arctoros/zebra/Hardware/VGA/finch.png

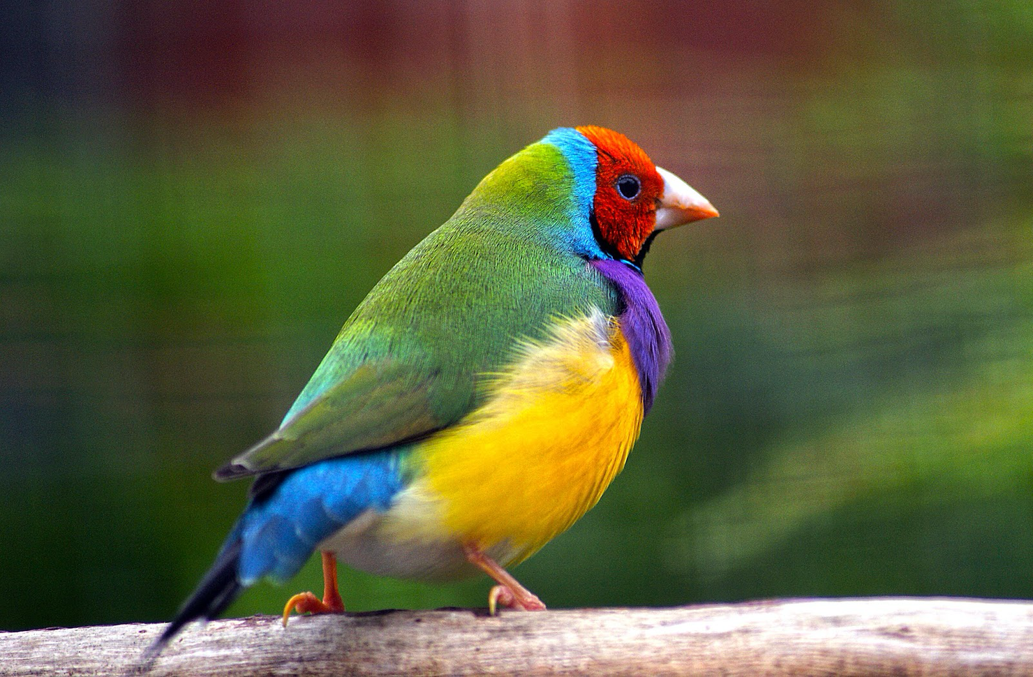
Hardware/VGA/finch.png
