arctoros/zebra/Hardware/VGA/finch4bit.png

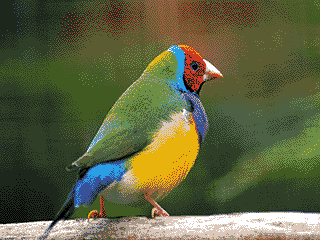
Hardware/VGA/finch4bit.png
