arctoros/zebra/Hardware/baud.xlsx

IOCLOCK | 3686400
Baud rate | 16
SIO Should be sending one bit every: | 0.0000043403 | s
One byte + start, parity, stop every: | 0.0000477431
SIO should be sending one byte every: | 381.9444444 | cycles
SIO IS sending one byte every: | 790 | cycles
every cycle lasts | 1.25e-07 | s
 | 9.875e-05
20945.45455 | 2.343217451
