arctoros/zebra/Hardware/Keyboard Map.xlsx

Index | IndexHex | Port B | Port A | Sign | Sec. Sign | ASCII | Sec. ASCII | Port B | Port A | Port B | Port A |  | Index
0 | 0 | 0 | 0 | ` | ~ | 60 | 7E | 00000001 | 00000001 | 0 | 0 | 0 | 0
1 | 1 | 0 | 1 | 8 | * | 38 | 2A | 00000001 | 00000010 | 0 | 1 | 0 | 1
2 | 2 | 0 | 2 | Tab |  | 0 | 0 | 00000001 | 00000100 | 0 | 2 | 0 | 2
3 | 3 | 0 | 3 | i | I | 69 | 49 | 00000001 | 00001000 | 0 | 3 | 0 | 3
4 | 4 | 0 | 4 | Esc |  | 1B | 0 | 00000001 | 00010000 | 0 | 4 | 0 | 4
5 | 5 | 0 | 5 | k | K | 6B | 4B | 00000001 | 00100000 | 0 | 5 | 0 | 5
6 | 6 | 0 | 6 | Shift |  | 0 | 0 | 00000001 | 01000000 | 0 | 6 | 0 | 6
7 | 7 | 0 | 7 | , | < | 2C | 3C | 00000001 | 10000000 | 0 | 7 | 0 | 7
8 | 8 | 1 | 0 | 1 | ! | 31 | 21 | 00000010 | 00000001 | 1 | 0 | 8 | 8
9 | 9 | 1 | 1 | 9 | ( | 39 | 28 | 00000010 | 00000010 | 1 | 1 | 8 | 9
10 | A | 1 | 2 | q | Q | 71 | 51 | 00000010 | 00000100 | 1 | 2 | 8 | 10
11 | B | 1 | 3 | o | O | 6F | 4F | 00000010 | 00001000 | 1 | 3 | 8 | 11
12 | C | 1 | 4 | a | A | 61 | 41 | 00000010 | 00010000 | 1 | 4 | 8 | 12
13 | D | 1 | 5 | l | L | 6C | 4C | 00000010 | 00100000 | 1 | 5 | 8 | 13
14 | E | 1 | 6 | z | Z | 7A | 5A | 00000010 | 01000000 | 1 | 6 | 8 | 14
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
