arctoros/zebra/Hardware/VGA/voltages.xlsx

r1 | r2 | r3 | r4 | number | perfect | reality | difference | 2nd try | difference | 3nd try | difference | 4nd try | difference
0 | 0 | 0 | 0 | 0 | 0 | 0 | 0.000 | 0 | 0.000 | 0 | 0.000 | 0 | 0.000
0 | 0 | 0 | 1 | 1 | 0.04666666667 | 0.07 | 0.023 | 0.052 | 0.005 | 0.064 | 0.017 | 0.064 | 0.017
0 | 0 | 1 | 0 | 2 | 0.09333333333 | 0.122 | 0.029 | 0.11 | 0.017 | 0.118 | 0.025 | 0.118 | 0.025 | higher
0 | 0 | 1 | 1 | 3 | 0.14 | 0.172 | 0.032 | 0.148 | 0.008 | 0.166 | 0.026 | 0.166 | 0.026
0 | 1 | 0 | 0 | 4 | 0.1866666667 | 0.222 | 0.035 | 0.18 | -0.007 | 0.23 | 0.043 | 0.222 | 0.035 | higher
0 | 1 | 0 | 1 | 5 | 0.2333333333 | 0.26 | 0.027 | 0.216 | -0.017 | 0.26 | 0.027 | 0.266 | 0.033
0 | 1 | 1 | 0 | 6 | 0.28 | 0.316 | 0.036 | 0.272 | -0.008 | 0.31 | 0.030 | 0.304 | 0.024
0 | 1 | 1 | 1 | 7 | 0.3266666667 | 0.346 | 0.019 | 0.308 | -0.019 | 0.352 | 0.025 | 0.338 | 0.011
1 | 0 | 0 | 0 | 8 | 0.3733333333 | 0.416 | 0.043 | 0.37 | -0.003 | 0.384 | 0.011 | 0.384 | 0.011
1 | 0 | 0 | 1 | 9 | 0.42 | 0.462 | 0.042 | 0.402 | -0.018 | 0.434 | 0.014 | 0.434 | 0.014
1 | 0 | 1 | 0 | 10 | 0.4666666667 | 0.504 | 0.037 | 0.458 | -0.009 | 0.446 | -0.021 | 0.446 | -0.021
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
