arctoros/zebra/Hardware/VGA/finch8bitgray.png

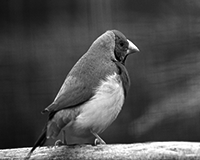
Hardware/VGA/finch8bitgray.png
