arctoros/zebra/Software/vga/converter/finch.png

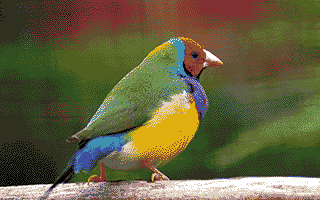
Software/vga/converter/finch.png
