arctoros/zebra/Hardware/Top.step

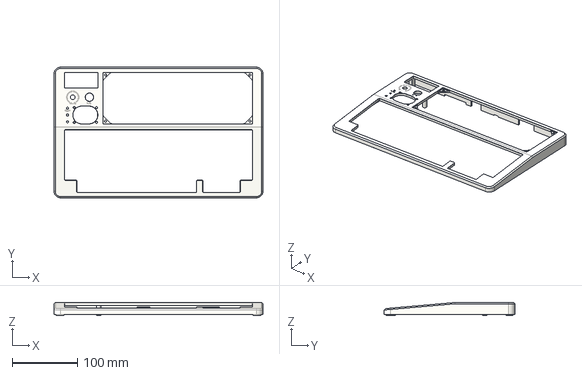
[picture p5: CAD file, 2025-11-17]
Hardware/Top.step
320.0 x 200.0 x 19.9 mm
