arctoros/zebra/Schematics/Symbols & Footprints/3D-Models/PLCC-68.stp

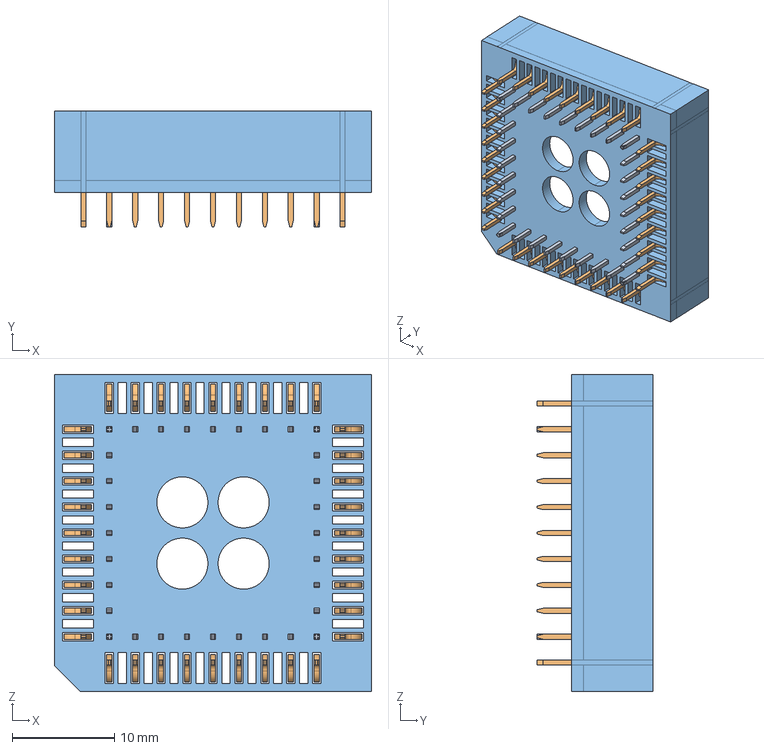
[picture p6: CAD file, 2025-11-17]
Schematics/Symbols & Footprints/3D-Models/PLCC-68.stp
31.1 x 11.4 x 31.1 mm
