arctoros/zebra/Hardware/Bottom.step

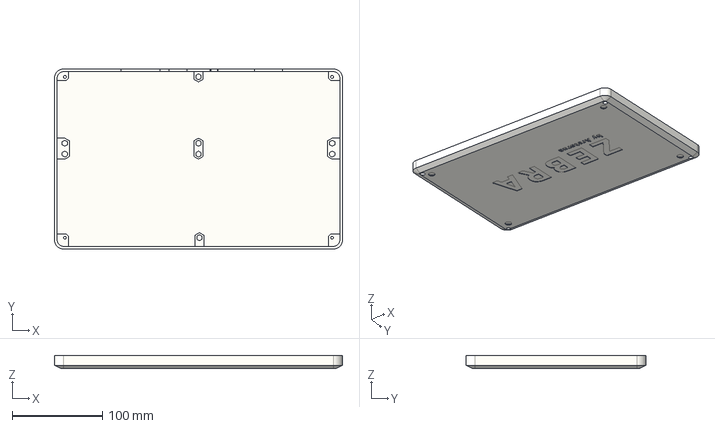
[picture p7: CAD file, 2025-11-17]
Hardware/Bottom.step
320.0 x 200.0 x 14.9 mm
