arctoros/zebra/Schematics/Symbols & Footprints/3D-Models/ZIF.stp

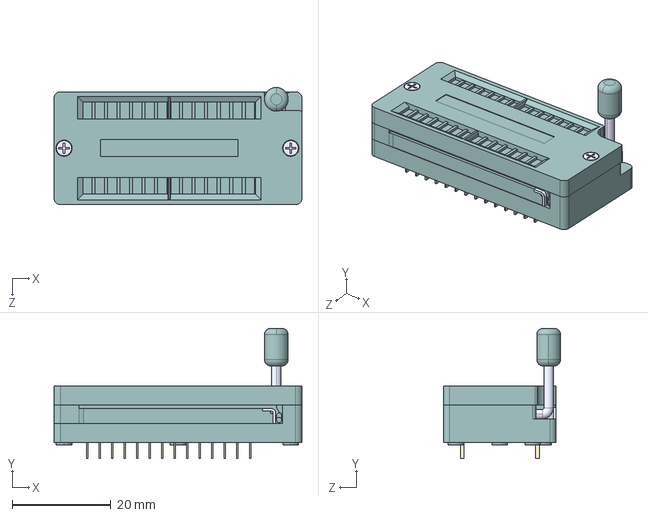
[picture p8: CAD file, 2025-11-17]
Schematics/Symbols & Footprints/3D-Models/ZIF.stp
50.3 x 26.4 x 23.7 mm
