arctoros/zebra/Schematics/Symbols & Footprints/3D-Models/PLCC-44.stp

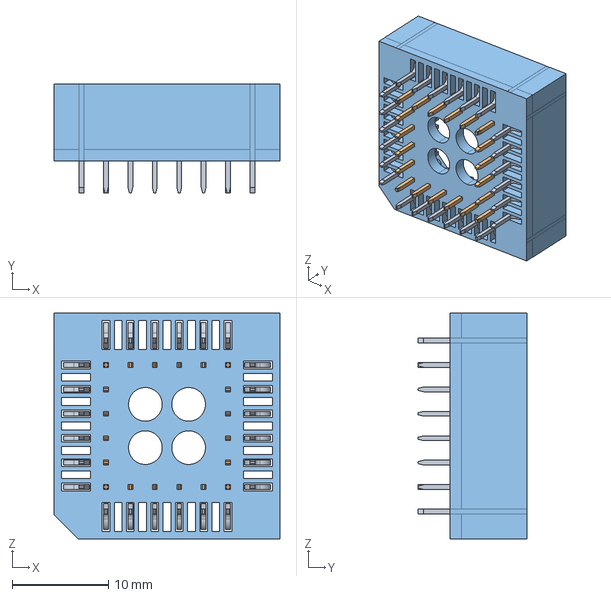
[picture p9: CAD file, 2025-11-17]
Schematics/Symbols & Footprints/3D-Models/PLCC-44.stp
23.5 x 11.4 x 23.5 mm
