arctoros/zebra/Schematics/Symbols & Footprints/3D-Models/MX.stp

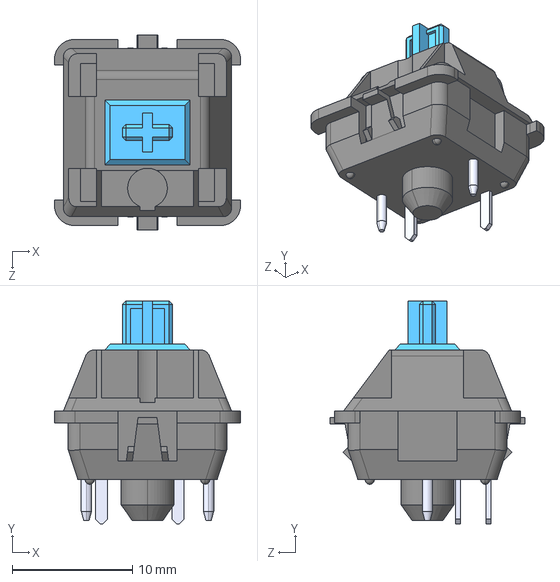
[picture p10: CAD file, 2025-11-17]
Schematics/Symbols & Footprints/3D-Models/MX.stp
15.5 x 18.5 x 16.2 mm
