arctoros/zebra/Schematics/Symbols & Footprints/3D-Models/PLCC-84.stp

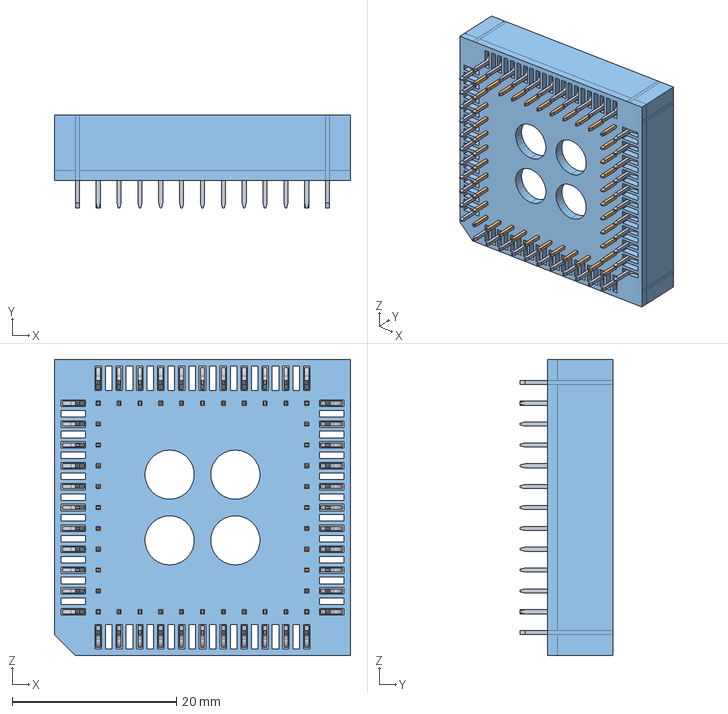
[picture p11: CAD file, 2025-11-17]
Schematics/Symbols & Footprints/3D-Models/PLCC-84.stp
36.1 x 11.4 x 36.0 mm
