arctoros/zebra/Schematics/Symbols & Footprints/3D-Models/POT.stp

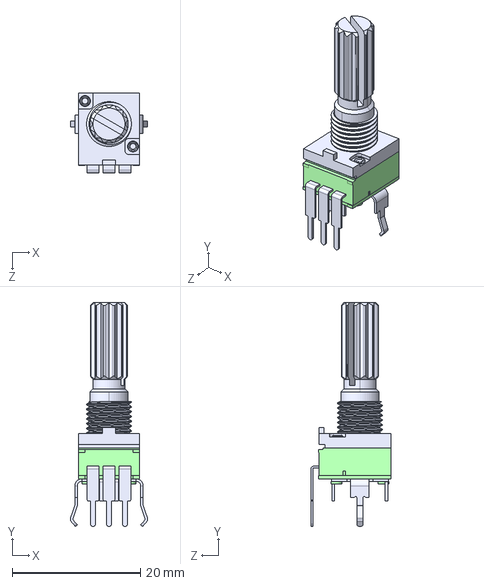
[picture p12: CAD file, 2025-11-17]
Schematics/Symbols & Footprints/3D-Models/POT.stp
12.1 x 35.0 x 12.5 mm
