arctoros/zebra/Schematics/Z80.kicad_sch

## KiCad design Schematics/Z80.kicad_sch (2025-11-17)

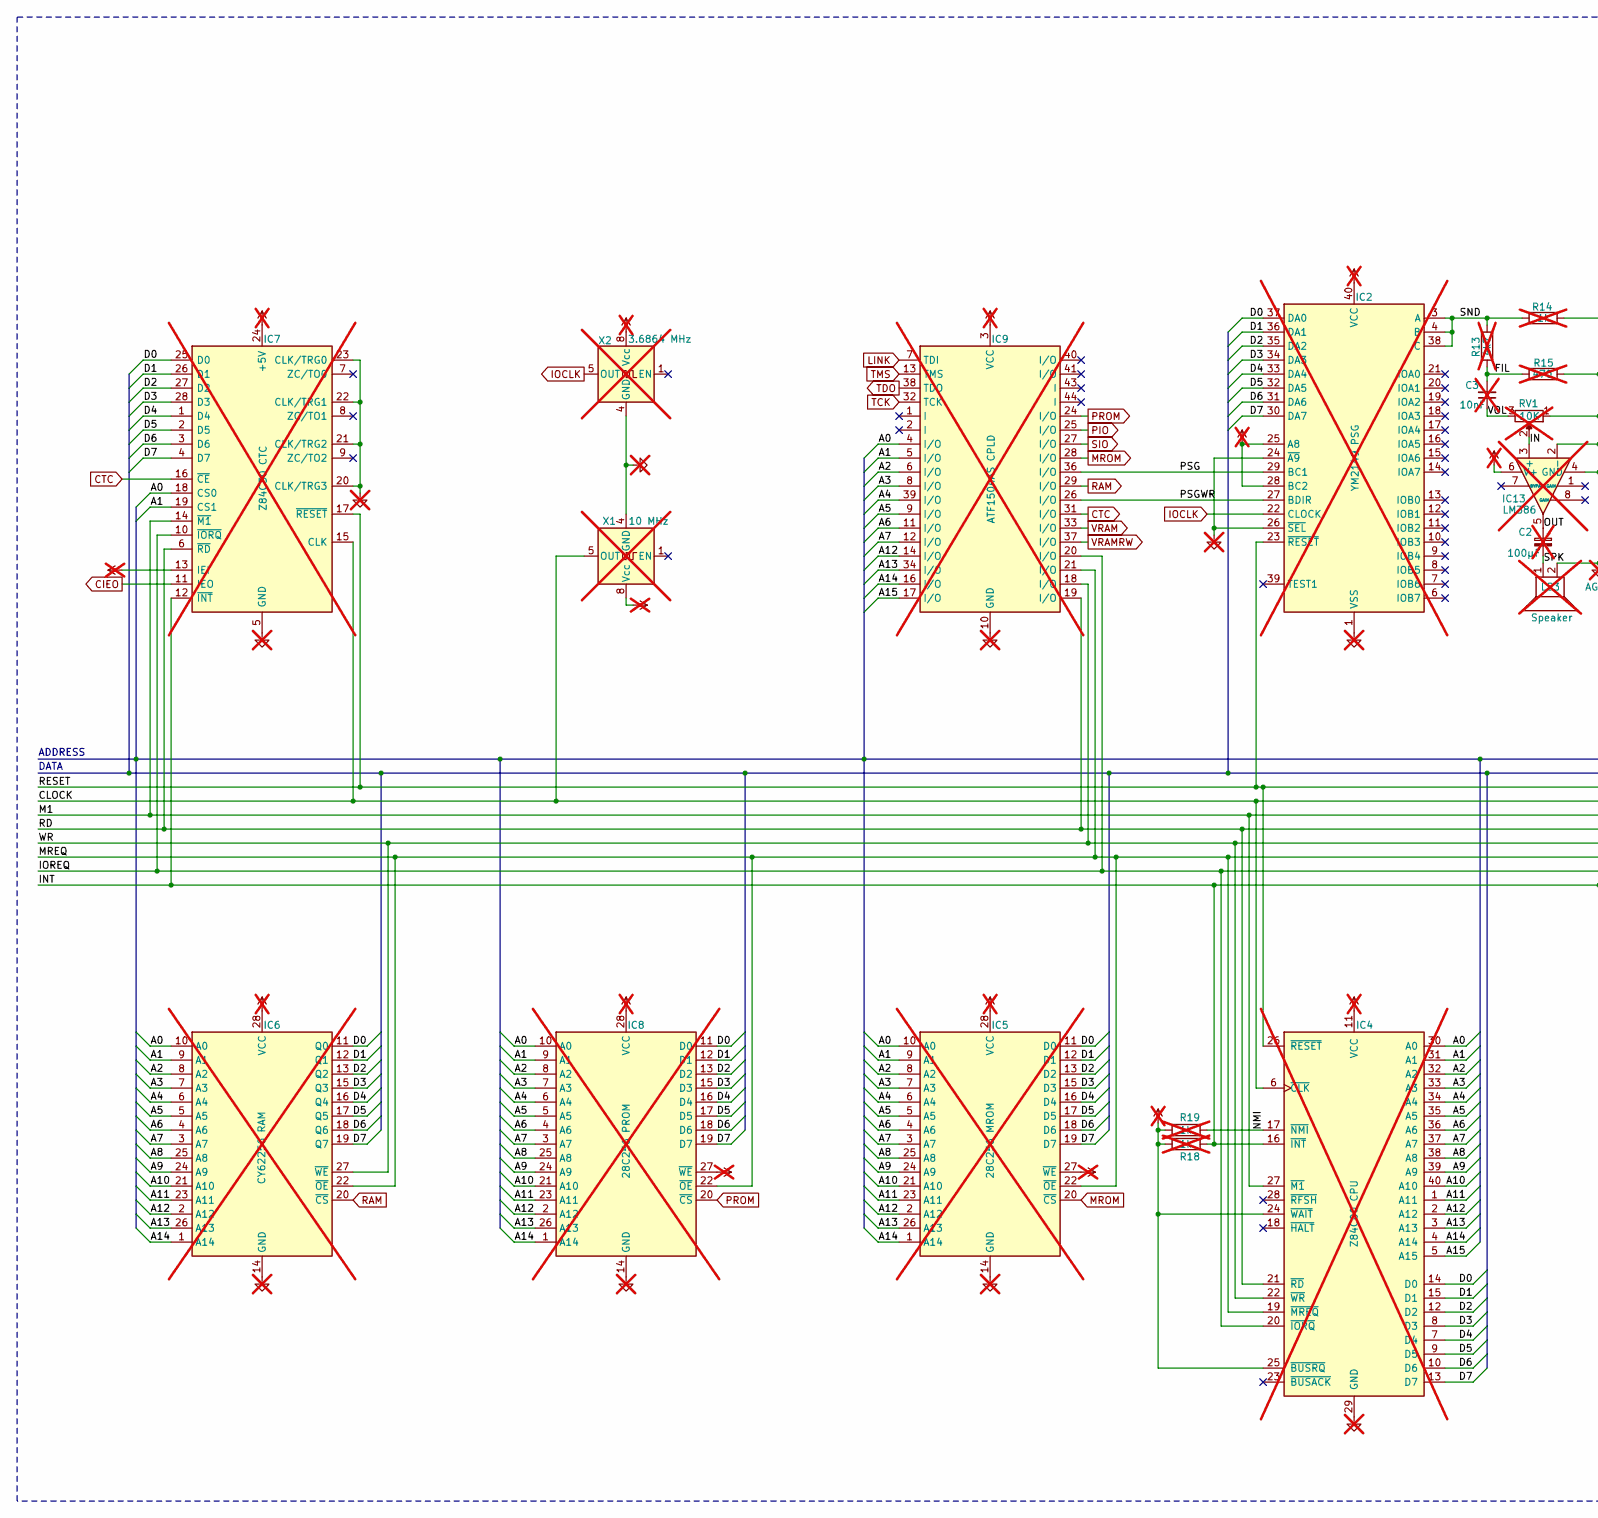
[picture p13: schematic Z80.kicad_sch, part in row 1, column 1]

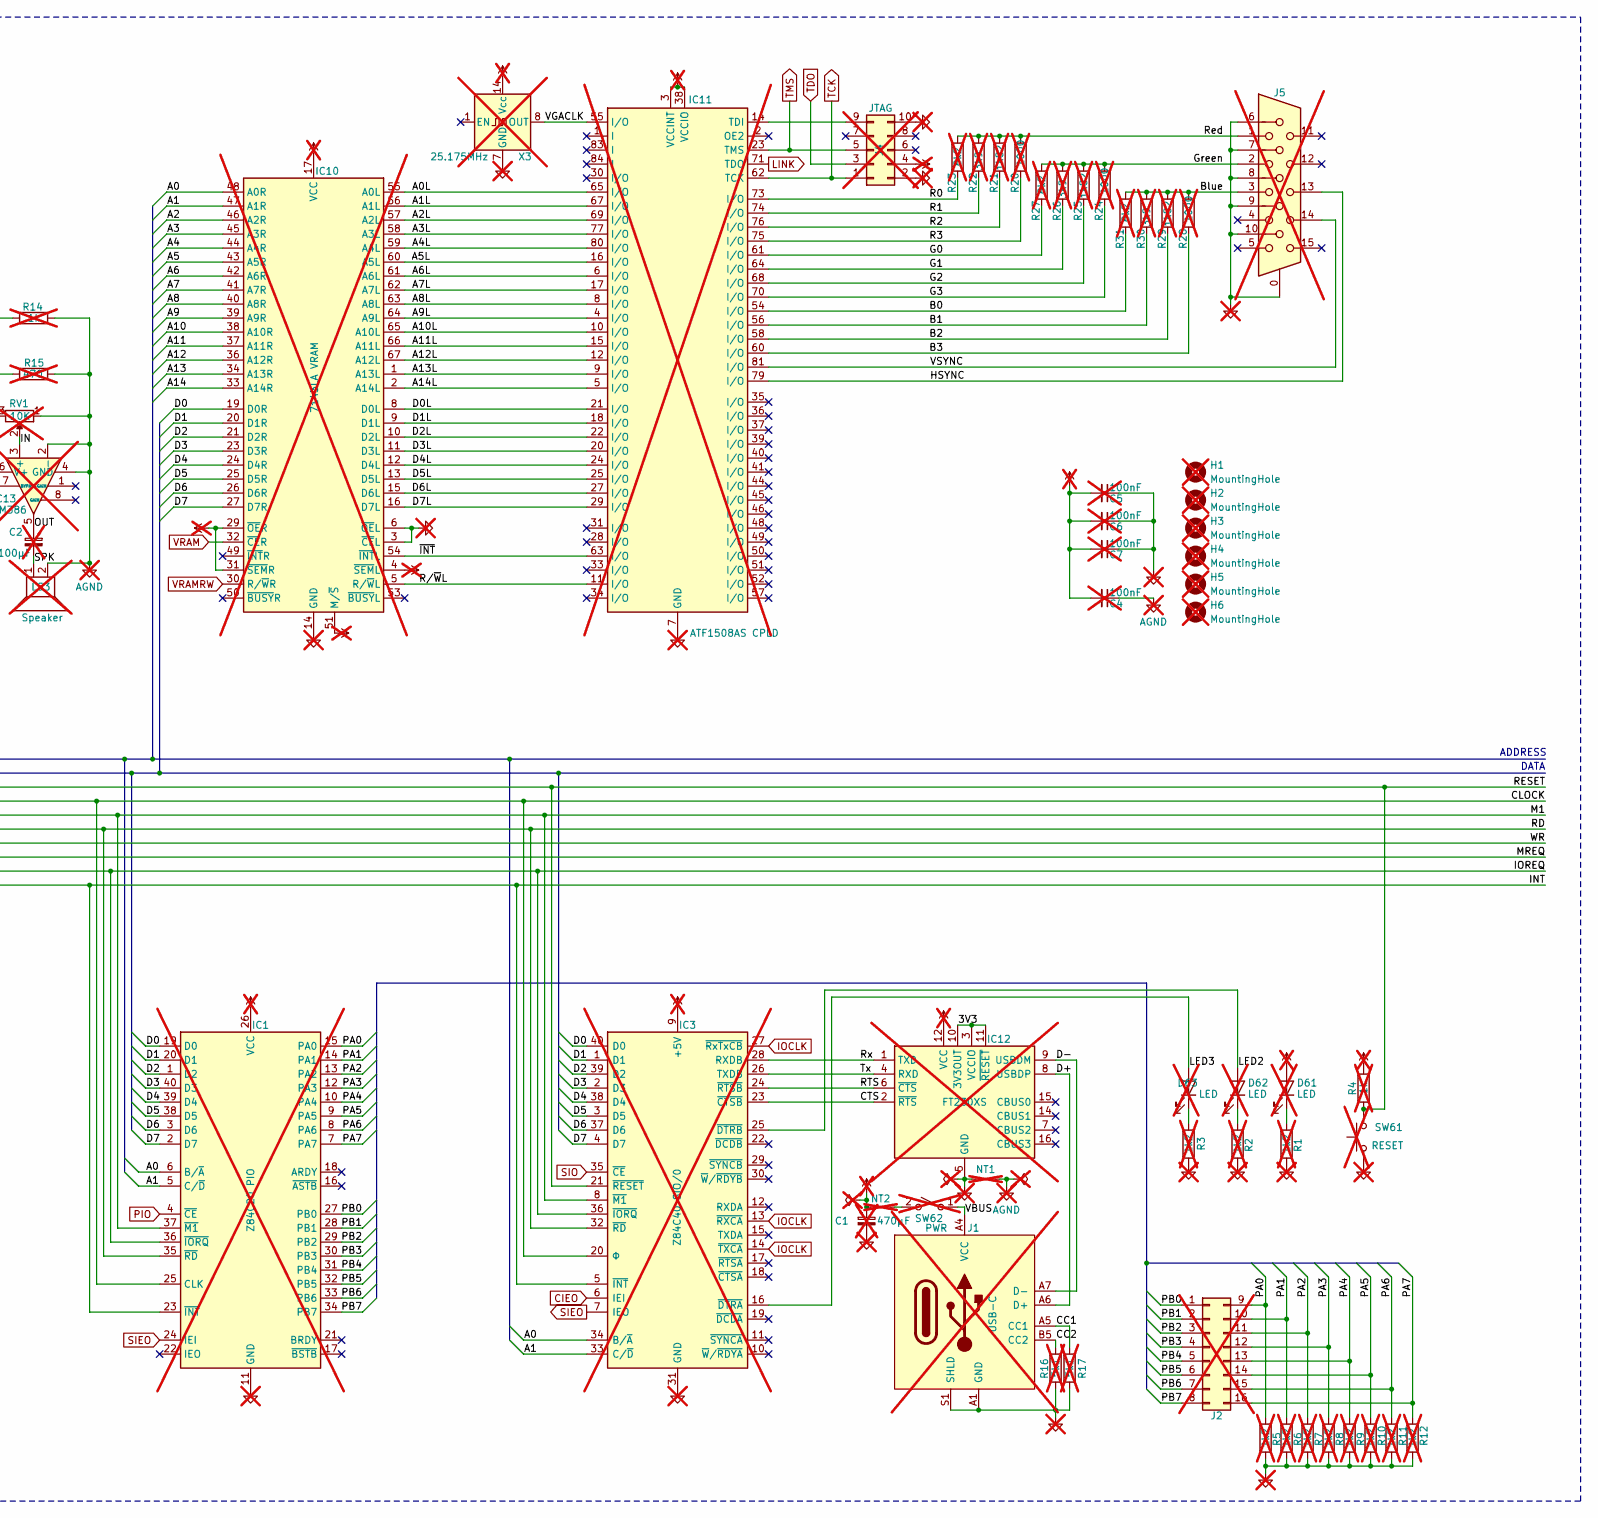
[picture p14: schematic Z80.kicad_sch, part in row 1, column 2]

Parts:
C1: 470μF; CP_Radial_D8.0mm; not fitted
C2: 100μF; CP_Radial_D5.0; not fitted
C3: 10nF; C_Disc_D3.0mm_W1.6mm_P2.50mm; not fitted
C4, C5, C6, C7: 100nF; C_Disc_D3.0mm_W1.6mm_P2.50mm; not fitted
D61, D62, D63: LED; LED_D3.0mm; not fitted
H1, H2, H3, H4, H5, H6: MountingHole; MountingHole_3.2mm_M3; not fitted
IC1: Z84C20 PIO; DIP-40_W15.24mm_Socket; LCSC Part # C2332; not fitted
IC2: YM2149 PSG; DIP-40_W15.24mm_Socket; LCSC Part # C2332; not fitted
IC3: Z84C40 SIO/0; DIP-40_W15.24mm_Socket; Manufacturer_Part_Number Z84C4206PEG; Mouser Part Number 692-Z84C4206PEG; not fitted
IC4: Z84C00 CPU; DIP-40_W15.24mm_Socket; LCSC Part # C2332; not fitted
IC5: 28C256 MROM; DIP-28_W15.24mm_Socket; not fitted
IC6: CY62256 RAM; DIP-28_W15.24mm_Socket; not fitted
IC7: Z84C30 CTC; DIP-28_W15.24mm_Socket; Manufacturer_Part_Number Z84C3010PEG; Mouser Part Number 692-Z84C3010PEG; not fitted
IC8: 28C256 PROM; DIP-28_W15.24mm_Socket; not fitted
IC9: ATF1504AS CPLD; PLCC-44_THT-Socket; not fitted
IC10: 7143LA VRAM; PLCC-68_THT-Socket; not fitted
IC11: ATF1508AS CPLD; PLCC-84_THT-Socket; not fitted
IC12: FT230XS; SSOP-16_3.9x4.9mm_P0.635mm; LCSC Part # C69082; not fitted
IC13: LM386; DIP-8_W7.62mm_Socket; not fitted
J1: USB-C; USB-C-New; LCSC Part # C2840393; not fitted
J2: Keyboard; PinSocket_1x16; not fitted
J4: JTAG; PinHeader_2x05_P2.54mm_Vertical; not fitted
J5: VGA; DSUB-15; not fitted
LS3: Speaker; PinHeader_1x02_P2.54mm_Vertical; not fitted
NT1: AGND; NetTie; not fitted
NT2: 5V; NetTie1.8; not fitted
R1, R2, R3, R5, R6, R7, R8, R9, R10, R11, R12: 1k2; R_Standard; not fitted
R4, R14, R18, R19: 1k; R_Standard; not fitted
R13: 4k7; R_Standard; not fitted
R15: 470; R_Standard; not fitted
R16, R17: 5k1; R_Standard; not fitted
R20, R24, R28: 1000; R_Standard; not fitted
R21, R25, R29: 1k82; R_Standard; not fitted
R22, R26, R30: 3k9; R_Standard; not fitted
R23, R27, R31: 8k2; R_Standard; not fitted
RV1: 10K; Potentiometer_Alpha_RD901F-40-00D_Single_Vertical_CircularH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; not fitted
SW61: RESET; PinHeader_1x02_P2.54mm_Vertical; not fitted
SW62: PWR; PinHeader_1x02_P2.54mm_Vertical; not fitted
X1: 10 MHz; Oscillator_DIP-8; not fitted
X2: 3.6864 MHz; Oscillator_DIP-8; not fitted
X3: 25.175MHz; Oscillator_DIP-14; not fitted

Connections:
3V3: IC12.3 (VCCIO), IC12.10 (3V3OUT), IC12.11 (~RESET)
+5V: C1.1, C4.2, C5.2, C6.2, C7.2, D61.2 (A), IC1.26 (VCC), IC2.25 (A8), IC2.28 (BC2), IC2.40 (VCC), IC3.9 (+5V), IC4.11 (VCC), IC4.24 (~WAIT), IC4.25 (~BUSRQ), IC5.27 (~WE), IC5.28 (VCC), IC6.28 (VCC), IC7.13 (IEI), IC7.24 (+5V), IC8.27 (~WE), IC8.28 (VCC), IC9.3 (VCC), IC9.15 (VCC), IC9.23 (VCC), IC9.35 (VCC), IC10.4 (~SEML), IC10.17 (VCC), IC10.22 (VCC), IC10.29 (~OER), IC10.31 (~SEMR), IC10.51 (M/~S), IC10.68 (VCC), IC11.3 (VCCINT), IC11.13 (VCCIO), IC11.26 (VCCIO), IC11.38 (VCCIO), IC11.43 (VCCIO), IC11.53 (VCCIO), IC11.66 (VCCIO), IC11.78 (VCCIO), IC12.12 (VCC), IC13.6 (V+), J4.4, NT2.2, R4.2, R18.2, R19.2, X1.8 (Vcc), X2.8 (Vcc), X3.14 (Vcc)
A0: IC1.6 (B/~A), IC3.34 (B/~A), IC4.30 (A0), IC5.10 (A0), IC6.10 (A0), IC7.18 (CS0), IC8.10 (A0), IC9.4 (I/O), IC10.48 (A0R)
A0L: IC10.55 (A0L), IC11.65 (I/O)
A1: IC1.5 (C/~D), IC3.33 (C/~D), IC4.31 (A1), IC5.9 (A1), IC6.9 (A1), IC7.19 (CS1), IC8.9 (A1), IC9.5 (I/O), IC10.47 (A1R)
A1L: IC10.56 (A1L), IC11.67 (I/O)
A2: IC4.32 (A2), IC5.8 (A2), IC6.8 (A2), IC8.8 (A2), IC9.6 (I/O), IC10.46 (A2R)
A2L: IC10.57 (A2L), IC11.69 (I/O)
A3: IC4.33 (A3), IC5.7 (A3), IC6.7 (A3), IC8.7 (A3), IC9.8 (I/O), IC10.45 (A3R)
A3L: IC10.58 (A3L), IC11.77 (I/O)
A4: IC4.34 (A4), IC5.6 (A4), IC6.6 (A4), IC8.6 (A4), IC9.39 (I/O), IC10.44 (A4R)
A4L: IC10.59 (A4L), IC11.80 (I/O)
A5: IC4.35 (A5), IC5.5 (A5), IC6.5 (A5), IC8.5 (A5), IC9.9 (I/O), IC10.43 (A5R)
A5L: IC10.60 (A5L), IC11.16 (I/O)
A6: IC4.36 (A6), IC5.4 (A6), IC6.4 (A6), IC8.4 (A6), IC9.11 (I/O), IC10.42 (A6R)
A6L: IC10.61 (A6L), IC11.6 (I/O)
A7: IC4.37 (A7), IC5.3 (A7), IC6.3 (A7), IC8.3 (A7), IC9.12 (I/O), IC10.41 (A7R)
A7L: IC10.62 (A7L), IC11.17 (I/O)
A8: IC4.38 (A8), IC5.25 (A8), IC6.25 (A8), IC8.25 (A8), IC10.40 (A8R)
A8L: IC10.63 (A8L), IC11.8 (I/O)
A9: IC4.39 (A9), IC5.24 (A9), IC6.24 (A9), IC8.24 (A9), IC10.39 (A9R)
A9L: IC10.64 (A9L), IC11.4 (I/O)
A10: IC4.40 (A10), IC5.21 (A10), IC6.21 (A10), IC8.21 (A10), IC10.38 (A10R)
A10L: IC10.65 (A10L), IC11.10 (I/O)
A11: IC4.1 (A11), IC5.23 (A11), IC6.23 (A11), IC8.23 (A11), IC10.37 (A11R)
A11L: IC10.66 (A11L), IC11.15 (I/O)
A12: IC4.2 (A12), IC5.2 (A12), IC6.2 (A12), IC8.2 (A12), IC9.14 (I/O), IC10.36 (A12R)
A12L: IC10.67 (A12L), IC11.12 (I/O)
A13: IC4.3 (A13), IC5.26 (A13), IC6.26 (A13), IC8.26 (A13), IC9.34 (I/O), IC10.34 (A13R)
A13L: IC10.1 (A13L), IC11.9 (I/O)
A14: IC4.4 (A14), IC5.1 (A14), IC6.1 (A14), IC8.1 (A14), IC9.16 (I/O), IC10.33 (A14R)
A14L: IC10.2 (A14L), IC11.5 (I/O)
A15: IC4.5 (A15), IC9.17 (I/O)
AGND: C4.1, IC13.2 (-), IC13.4 (GND), LS3.2, NT1.2, R14.2, R15.2, RV1.1
B0: IC11.54 (I/O), R31.2
B1: IC11.56 (I/O), R30.2
B2: IC11.58 (I/O), R29.2
B3: IC11.60 (I/O), R28.2
Blue: J5.3, R28.1, R29.1, R30.1, R31.1
CC1: J1.A5 (CC1), R17.1
CC2: J1.B5 (CC2), R16.1
CIEO: IC3.6 (IEI), IC7.11 (IEO)
CLOCK: IC1.25 (CLK), IC3.20 (Φ), IC4.6 (~CLK), IC7.15 (CLK), X1.5 (OUT)
CTC: IC7.16 (~CE), IC9.31 (I/O)
CTS: IC3.23 (~CTSB), IC12.2 (~RTS)
D0: IC1.19 (D0), IC2.37 (DA0), IC3.40 (D0), IC4.14 (D0), IC5.11 (D0), IC6.11 (Q0), IC7.25 (D0), IC8.11 (D0), IC10.19 (D0R)
D0L: IC10.8 (D0L), IC11.21 (I/O)
D1: IC1.20 (D1), IC2.36 (DA1), IC3.1 (D1), IC4.15 (D1), IC5.12 (D1), IC6.12 (Q1), IC7.26 (D1), IC8.12 (D1), IC10.20 (D1R)
D1L: IC10.9 (D1L), IC11.18 (I/O)
D2: IC1.1 (D2), IC2.35 (DA2), IC3.39 (D2), IC4.12 (D2), IC5.13 (D2), IC6.13 (Q2), IC7.27 (D2), IC8.13 (D2), IC10.21 (D2R)
D2L: IC10.10 (D2L), IC11.22 (I/O)
D3: IC1.40 (D3), IC2.34 (DA3), IC3.2 (D3), IC4.8 (D3), IC5.15 (D3), IC6.15 (Q3), IC7.28 (D3), IC8.15 (D3), IC10.23 (D3R)
D3L: IC10.11 (D3L), IC11.20 (I/O)
D4: IC1.39 (D4), IC2.33 (DA4), IC3.38 (D4), IC4.7 (D4), IC5.16 (D4), IC6.16 (Q4), IC7.1 (D4), IC8.16 (D4), IC10.24 (D4R)
D4L: IC10.12 (D4L), IC11.24 (I/O)
D5: IC1.38 (D5), IC2.32 (DA5), IC3.3 (D5), IC4.9 (D5), IC5.17 (D5), IC6.17 (Q5), IC7.2 (D5), IC8.17 (D5), IC10.25 (D5R)
D5L: IC10.13 (D5L), IC11.25 (I/O)
D6: IC1.3 (D6), IC2.31 (DA6), IC3.37 (D6), IC4.10 (D6), IC5.18 (D6), IC6.18 (Q6), IC7.3 (D6), IC8.18 (D6), IC10.26 (D6R)
D6L: IC10.15 (D6L), IC11.27 (I/O)
D7: IC1.2 (D7), IC2.30 (DA7), IC3.4 (D7), IC4.13 (D7), IC5.19 (D7), IC6.19 (Q7), IC7.4 (D7), IC8.19 (D7), IC10.27 (D7R)
D7L: IC10.16 (D7L), IC11.29 (I/O)
D+: IC12.8 (USBDP), J1.A6 (D+), J1.B6 (D+)
D-: IC12.9 (USBDM), J1.A7 (D-), J1.B7 (D-)
FIL: C3.2, R13.1, R15.1
G0: IC11.61 (I/O), R27.2
G1: IC11.64 (I/O), R26.2
G2: IC11.68 (I/O), R25.2
G3: IC11.70 (I/O), R24.2
GND: C1.2, C5.1, C6.1, C7.1, IC1.11 (GND), IC2.1 (VSS), IC2.24 (~A9), IC2.26 (~SEL), IC3.31 (GND), IC4.29 (GND), IC5.14 (GND), IC6.14 (GND), IC7.5 (GND), IC7.20 (CLK/TRG3), IC7.21 (CLK/TRG2), IC7.22 (CLK/TRG1), IC7.23 (CLK/TRG0), IC8.14 (GND), IC9.10 (GND), IC9.22 (GND), IC9.30 (GND), IC9.42 (GND), IC10.3 (~CEL), IC10.6 (~OEL), IC10.14 (GND), IC10.18 (GND), IC10.35 (GND), IC10.52 (GND), IC11.7 (GND), IC11.19 (GND), IC11.32 (GND), IC11.42 (GND), IC11.47 (GND), IC11.59 (GND), IC11.72 (GND), IC11.82 (GND), IC12.5 (GND), IC12.13 (GND), J1.A1 (GND), J1.A12 (GND), J1.B1 (GND), J1.B12 (GND), J1.S1 (SHLD), J4.2, J4.10, J5.0, J5.6, J5.7, J5.8, J5.9, J5.10, NT1.1, R1.2, R2.2, R3.2, R5.2, R6.2, R7.2, R8.2, R9.2, R10.2, R11.2, R12.2, R16.2, R17.2, SW61.2 (B), X1.4 (GND), X2.4 (GND), X3.7 (GND)
Green: J5.2, R24.1, R25.1, R26.1, R27.1
HSYNC: IC11.79 (I/O), J5.13
IN: IC13.3 (+), RV1.2
INT: IC1.23 (~INT), IC3.5 (~INT), IC4.16 (~INT), IC7.12 (~INT), R18.1
IOCLK: IC2.22 (CLOCK), IC3.13 (~RXCA), IC3.14 (~TXCA), IC3.27 (~RxTxCB), X2.5 (OUT)
IOREQ: IC1.36 (~IORQ), IC3.36 (~IORQ), IC4.20 (~IORQ), IC7.10 (~IORQ), IC9.20 (I/O)
LED2: D62.2 (A), IC3.25 (~DTRB)
LED3: D63.2 (A), IC3.16 (~DTRA)
LINK: IC9.7 (TDI), IC11.71 (TDO)
M1: IC1.37 (~M1), IC3.8 (~M1), IC4.27 (~M1), IC7.14 (~M1)
MREQ: IC4.19 (~MREQ), IC5.22 (~OE), IC6.22 (~OE), IC8.22 (~OE), IC9.21 (I/O)
MROM: IC5.20 (~CS), IC9.28 (I/O)
NMI: IC4.17 (~NMI), R19.1
unnamed: D61.1 (K), R1.1
unnamed: D62.1 (K), R2.1
unnamed: D63.1 (K), R3.1
unnamed: IC10.7 (N/C), IC10.28 (N/C)
unnamed: IC11.14 (TDI), J4.9
unnamed: J1.A8 (SBU1), J1.B8 (SBU2)
unnamed: NT2.1, SW62.2 (B)
OUT: C2.1, IC13.5
PA0: IC1.15 (PA0), J2.9, R5.1
PA1: IC1.14 (PA1), J2.10, R6.1
PA2: IC1.13 (PA2), J2.11, R7.1
PA3: IC1.12 (PA3), J2.12, R8.1
PA4: IC1.10 (PA4), J2.13, R9.1
PA5: IC1.9 (PA5), J2.14, R10.1
PA6: IC1.8 (PA6), J2.15, R11.1
PA7: IC1.7 (PA7), J2.16, R12.1
PB0: IC1.27 (PB0), J2.1
PB1: IC1.28 (PB1), J2.2
PB2: IC1.29 (PB2), J2.3
PB3: IC1.30 (PB3), J2.4
PB4: IC1.31 (PB4), J2.5
PB5: IC1.32 (PB5), J2.6
PB6: IC1.33 (PB6), J2.7
PB7: IC1.34 (PB7), J2.8
PIO: IC1.4 (~CE), IC9.25 (I/O)
PROM: IC8.20 (~CS), IC9.24 (I/O)
PSG: IC2.29 (BC1), IC9.36 (I/O)
PSGWR: IC2.27 (BDIR), IC9.26 (I/O)
R0: IC11.73 (I/O), R23.2
R1: IC11.74 (I/O), R22.2
R2: IC11.76 (I/O), R21.2
R3: IC11.75 (I/O), R20.2
RAM: IC6.20 (~CS), IC9.29 (I/O)
RD: IC1.35 (~RD), IC3.32 (~RD), IC4.21 (~RD), IC7.6 (~RD), IC9.19 (I/O)
RESET: IC2.23 (~RESET), IC3.21 (~RESET), IC4.26 (~RESET), IC7.17 (~RESET), R4.1, SW61.1 (A)
RTS: IC3.24 (~RTSB), IC12.6 (~CTS)
Red: J5.1, R20.1, R21.1, R22.1, R23.1
Rx: IC3.28 (RXDB), IC12.1 (TXD)
R/~WL: IC10.5 (R/~WL), IC11.11 (I/O)
SIEO: IC1.24 (IEI), IC3.7 (IEO)
SIO: IC3.35 (~CE), IC9.27 (I/O)
SND: IC2.3 (A), IC2.4 (B), IC2.38 (C), R13.2, R14.1
SPK: C2.2, LS3.1
TCK: IC9.32 (TCK), IC11.62 (TCK), J4.1
TDO: IC9.38 (TDO), J4.3
TMS: IC9.13 (TMS), IC11.23 (TMS), J4.5
Tx: IC3.26 (TXDB), IC12.4 (RXD)
VBUS: J1.A4 (VCC), J1.A9 (VCC), J1.B4 (VCC), J1.B9 (VCC), SW62.1 (A)
VGACLK: IC11.55 (I/O), X3.8 (OUT)
VOL: C3.1, RV1.3
VRAM: IC9.33 (I/O), IC10.32 (~CER)
VRAMRW: IC9.37 (I/O), IC10.30 (R/~WR)
VSYNC: IC11.81 (I/O), J5.14
WR: IC4.22 (~WR), IC6.27 (~WE), IC9.18 (I/O)
~INT: IC10.54 (~INTL), IC11.63 (I/O)

Notes on the sheet:
DATA
ADDRESS
