arctoros/zebra/Software/vga/vga.asm

;+-- Symbols ---
;Only Port B is hooked up
SIO_DATA = %00000001					; Port B data register
SIO_CMD	= %00000011						; Port B command register

PIO_IN_DATA = %00010000 			; Port A data register
PIO_IN_CMD = %00010010 				; Port A command register
PIO_OUT_DATA = %00010001 			; Port B data register
PIO_OUT_CMD = %00010011 			; Port B command register

CTC_C0 = %00110000						; Channel 0
CTC_C1 = %00110001						; Channel 1
CTC_C2 = %00110010						; Channel 2
CTC_C3 = %00110011						; Channel 3

PSG_INACT = %00100000					; BDIR Low, BC1 Low
PSG_READ  = %00100001					; BDIR Low, BC1 High
PSG_WRITE = %00100010					; BDIR High, BC1 Low
PSG_ADDR  = %00100011					; BDIR High, BC1 High

; RAM
STACK = $5000
KEYBOARD_TIMER = $5FFF 
KEYBOARD_MAP = $6000					; Low order byte should be $00
;---

;+-- Reset --- 
        .org $8000

reset:
				;+-- CPU Initialisation
				ld sp, STACK
				ld a, hi(intVectors)
				ld i, a
				im 2
				ei
				;---

				;+-- SIO Initialisation
				ld a, %00000011       ; Select WR3
        out (SIO_CMD), a
        ld a, %11000001
				;      ││     └─────── Rx Enable
				;      └┴───────────── 8 bits per character
        out (SIO_CMD), a

        ld a, %00000100       ; Select WR4
        out (SIO_CMD), a
        ld a, %01000111
				;      │││││││└─────── Parity Enable
				;      ││││││└──────── Parity Even
				;      ││││└┴───────── 1 Stop Bit
				;      ││└┴─────────── Sync Mode Disable
				;      └┴───────────── X32 Clock Mode 
        out (SIO_CMD), a

				ld a, %00000101       ; Select WR5
        out (SIO_CMD), a
        ld a, %01101000
				;       ││ └────────── Tx Enable
				;       └┴──────────── 8 bits per character 
        out (SIO_CMD), a 
				;---

				;+-- PIO Initialisation
				ld a, %00001111
				;      ││││└┴┴┴─────── Identifies Mode Control Word 
				;      ││└┴─────────── Don't care 
				;      └┴───────────── Mode 0 (Output)
				out (PIO_OUT_CMD), a	; Write to output port command register

				ld a, %01001111
				;      ││││└┴┴┴─────── Identifies Mode Control Word 
				;      ││└┴─────────── Don't care 
				;      └┴───────────── Mode 1 (Input)
				out (PIO_IN_CMD), a		; Write to input port command register
				;---

				;+-- CTC Initialisation
				ld a, lo(CTCVec)
        out (CTC_C0), a
        
				ld a, %10100101
				;      │││ │││└─────── Control Word
				;      │││ ││└──────── Continued Operation
				;      │││ │└───────── Time Constant Follows
				;      │││ └────────── Automatic trigger
				;      ││└──────────── Prescaler Value = 256 
				;      │└───────────── Select Timer Mode
				;      └────────────── Enable Interrupts 
        out (CTC_C0), a

				ld a, $1F							; Start Timer
				out (CTC_C0), a
				
				ld (KEYBOARD_TIMER), a ; Init Keyboard Timer to $FF
				;---

				;+-- Reset Keyboad Map
				ld b, 8
				ld hl, KEYBOARD_MAP
resetKeyboardMap:
				ld (hl), 0
				inc hl
				djnz resetKeyboardMap
				
				ld a, ">"
				call print
				;--- 
;---

;+-- Loop ---
				di
				ld bc, image
				ld hl, $8000
wipe:
				ld a, (bc)
				ld (hl), a
				inc bc
				inc hl
				ld a, h
				or l
				jp nz, wipe

loop:
				jp loop
;---

;+-- Subroutines
.local
print::
				push bc
				out (SIO_DATA), a			; Print A to SIO
				ld b, 40
delay:	djnz delay						; 7 + 13 * 28 + 8 = 379 T
				pop bc
				ret
.endlocal

.local
strobe::
				push af
				push de
				push hl
				ld d, %00000001				; Load the initial output coordinate
				ld hl, KEYBOARD_MAP		; Load the initial address of the keyboard map pointer
bitBang:
				ld a, d								; Load in the next bit
				out (PIO_OUT_DATA), a ; Strobe the next bit
				in a, (PIO_IN_DATA)		; Read back the input coordinate
				ld (hl), a						; Load the ready byte into ram at keyboard map pointer
				inc l									; Increment keyboard map pointer
				sla d									; Shit output coordinate left by 1
				jp nc, bitBang 				; Break if carry is set (Bit has arrived)

				pop hl
				pop de
				pop af
				ret
.endlocal

.local
printCharacters::
				push af
				push bc
				push de
				push hl

				ld bc, 0							; B is data byte, C is bit index
				ld de, 0							; D is shift bit, E is unused
				ld hl, KEYBOARD_MAP		; hl is map pointer, l is byte index
				ld b, (hl)						; Load 0th byte of map
				ld a, b
				and %01000000					; Mask the shift bit
				ld d, a								; Store shift bit in D

loop:
				bit 0, b							; Test the 0th bit
				jp z, next						; Jump if clear
															; If bit is set:
				push bc
				push hl				
				ld a, l								; Load in the byte index
				sla a									; Byte Index << 3
				sla a
				sla a
				add c									; Add bit index
				or d									; Set the shift bit accordingly
				
				ld h, hi(IndexToASCII); Load the ASCII LUT offset
				ld l, a								; Load the index into low-order byte
				ld a, (hl)						; Retrieve ASCII character with index
				cp 0									; Set the condition flags
				call nz, print				; Only print if not null
		
				pop hl
				pop bc

next:
				srl b									; Shift byte right
				ld a, 8
				inc c									; Increment bit index
				cp c									; Compare bit index to 8
				jp nz, loop				; Repeat if C != 8

				ld c, 0								; If C = 8, reset C
				ld a, lo(KEYBOARD_MAP + 8)	; Load the last address of map
				inc hl								; Increment byte index
				ld b, (hl)						; Load in next byte of map
				cp l									; Compare byte index to last address
				jp nz, loop				; Repeat if not arrived at last address
				
				pop hl
				pop de
				pop bc
				pop af
				ret										; Else, return
.endlocal
;---

;+-- Interrupt Handlers
				.org $8F00
intVectors:
CTCVec:	DB lo(CTCInt), hi(CTCInt)
SIOVec:	DB lo(SIOInt), hi(CTCInt)

CTCInt:				
				call strobe

				ld a, (KEYBOARD_TIMER)
				dec a
				ld (KEYBOARD_TIMER), a
				call z, printCharacters

				ld a, %10100101
        out (CTC_C0), a
				ld a, $1F							; Start Timer
				out (CTC_C0), a

				ei
				reti

SIOInt:
				ei
				reti
;---

;+-- Look-up Tables
				.org $8100					; LSB should be $00
IndexToASCII:
    		DB 60h, 38h, 00h, 69h, 1Bh, 6Bh, 00h, 2Ch
   			DB 31h, 39h, 71h, 6Fh, 61h, 6Ch, 7Ah, 2Eh
				DB 32h, 30h, 77h, 70h, 73h, 3Bh, 78h, 2Fh
				DB 33h, 2Dh, 65h, 5Bh, 64h, 27h, 63h, 00h
				DB 34h, 3Dh, 72h, 5Dh, 66h, 0Ah, 76h, 00h
				DB 35h, 08h, 74h, 5Ch, 67h, 00h, 62h, 00h
				DB 36h, 00h, 79h, 00h, 68h, 00h, 6Eh, 00h
				DB 37h, 00h, 75h, 00h, 6Ah, 20h, 6Dh, 00h

				DB 7Eh, 2Ah, 00h, 49h, 1Bh, 4Bh, 00h, 3Ch
				DB 21h, 28h, 51h, 4Fh, 41h, 4Ch, 5Ah, 3Eh
				DB 40h, 29h, 57h, 50h, 53h, 3Ah, 58h, 3Fh
				DB 23h, 5Fh, 45h, 7Bh, 44h, 22h, 43h, 00h
				DB 24h, 2Bh, 52h, 7Dh, 46h, 0Ah, 56h, 00h
				DB 25h, 08h, 54h, 7Ch, 47h, 00h, 42h, 00h
				DB 5Eh, 00h, 59h, 00h, 48h, 00h, 4Eh, 00h
				DB 26h, 00h, 55h, 00h, 4Ah, 20h, 4Dh, 00h

				.org $8200					; LSB should be $00
PSGCommands:
				DB $DE							; R0, Port A fine adjustment = $DE
				DB $01							; R1, Port A coarse adjustment = $01
				DB $00							; R2, Clear
				DB $00							; R3, Clear
				DB $00							; R4, Clear
				DB $00							; R5, Clear
				DB $00							; R6, Clear
				DB $FE							; R7, Tone Enable on Channel A, Noise Disable, Input Disable
				DB $0F							; R8, Full Volume
				DB $00							; R9, Clear
				DB $00							; RA, Clear
				DB $00							; RB, Clear
				DB $00							; RC, Clear
				DB $00							; RD, Clear
				DB $00							; RE, Clear
				DB $00							; RF, Clear

image:
				.incbin "out80x50.bin"
;---
